NJIT-Highlander-Racing-Electrical/Pedal-Sensors/3D Models/Gas Pedal Sensor Adapter.step

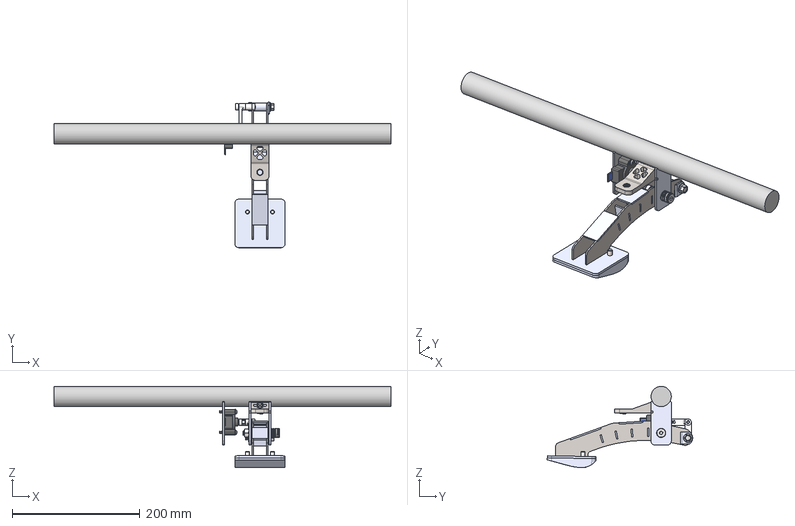
[picture p1: CAD file, 2025-04-19, last stored version]
3D Models/Gas Pedal Sensor Adapter.step
528.2 x 228.2 x 127.4 mm
Gas Pedal Plate (without bend)
Pedal Stop Target
hex nut_ai_1 x 3
Pedal Reinforcement Plate
socket head cap screw_ai x 2
Throttle Cable Bolt Sleeve
Gas Pedal Side (right) 2.0 x 2
91259A628_Alloy Steel Shoulder Screw
Pedal Mounting Tabs 2.0 x 2
Pedal Stop Tab 2.0
3726N174_Corrosion-Resistant Stacked Wave Disc Spring
Throttle Clamp
Gas Pedal Gussets x 4
6389K625_Light Duty Dry-Running Nylon Sleeve Bearing x 2
Gas Pedal Curved Face Extension 1.0
hex nut_ai
92979A130_Zinc-Plated Grade 5 Steel Flanged Hex Head Screws
Rotary Hall Effect Pedal Sensor PSC360G2-F2AA-C0002-ERA360-05K
92095A197_Button Head Hex Drive Screw x 2
98269A430_Black-Oxide 18-8 Stainless Steel Washer x 2
Upper Linkage
Lower Linkage (+90, original)
Tab
Retaining Clip 2
Retaining Clip
