NJIT-Highlander-Racing-Electrical/Pedal-Sensors/(list of files, cad)

Other CAD files:
3D Models/Gas Pedal Sensor Adapter.f3z
