NJIT-Highlander-Racing-Electrical/Pedal-Sensors/PCB/PedalPCB.kicad_pcb

## KiCad design PCB/PedalPCB.kicad_pcb (2024-12-06, last stored version)

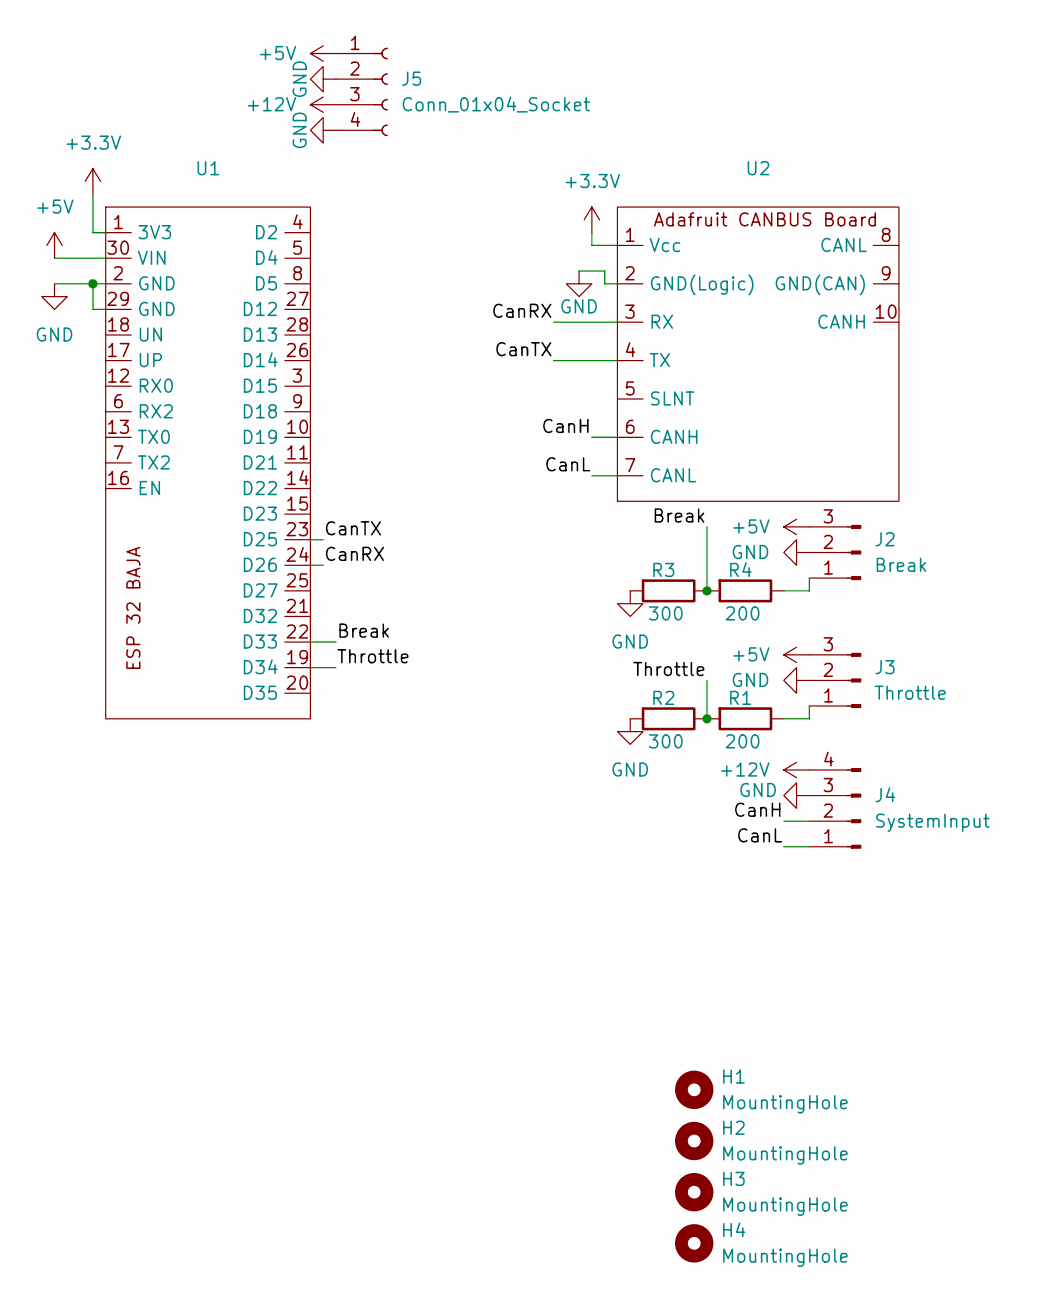
[picture p2: schematic PedalPCB.kicad_sch]

Parts:
H1, H2, H3, H4: MountingHole; MountingHole_4.3mm_M4
J2: Break; 3pin
J3: Throttle; 3pin
J4: SystemInput; JST4Pin
J5: Conn_01x04_Socket; PowerBoard
R1, R4: 200; R_Axial_DIN0204_L3.6mm_D1.6mm_P5.08mm_Horizontal
R2, R3: 300; R_Axial_DIN0204_L3.6mm_D1.6mm_P5.08mm_Horizontal
U1: ESP 32 BAJA
U2: 1x7 Connectors

Connections:
+3.3V: U1.1 (3V3), U2.1 (Vcc)
+5V: J2.3, J3.3, J5.1 (+5v), U1.30 (VIN)
+12V: J4.4, J5.3 (12+)
/Break: R3.1, R4.2, U1.22 (D33)
/CanH: J4.2, U2.6 (CANH)
/CanL: J4.1, U2.7 (CANL)
/CanRX: U1.24 (D26), U2.3 (RX)
/CanTX: U1.23 (D25), U2.4 (TX)
/Throttle: R1.2, R2.1, U1.19 (D34)
GND: J2.2, J3.2, J4.3, J5.2 (GND), J5.4 (GND), R2.2, R3.2, U1.2 (GND), U1.29 (GND), U2.2 (GND(Logic))
unnamed: J2.1, R4.1
unnamed: J3.1, R1.1

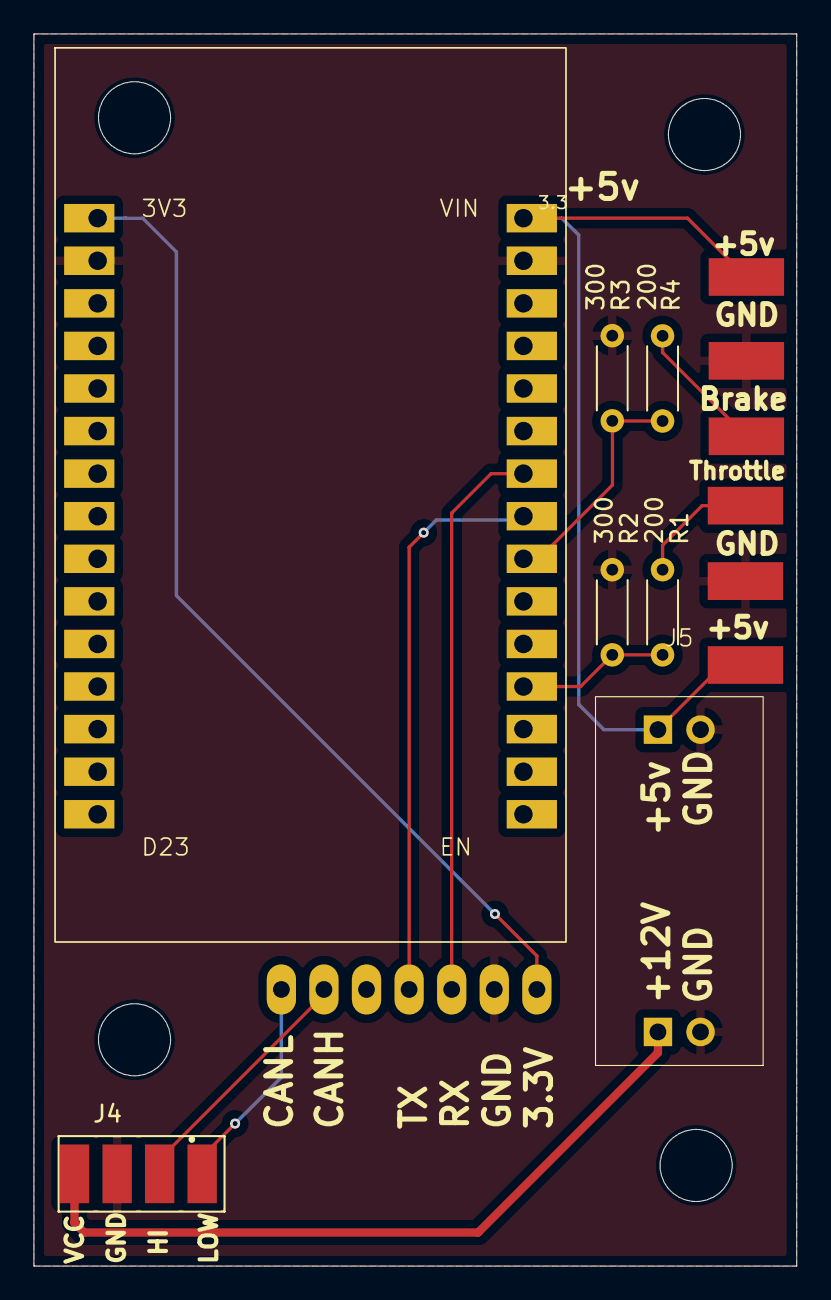
[picture p3: board PedalPCB.kicad_pcb from above]

Board: 2 copper layers, 45.5 x 73.5 mm, 14 parts (1 on the bottom side), 12 nets.

Other parts of the board:
H1#2: MountingHole; MountingHole_4.3mm_M4
