NJIT-Highlander-Racing-Electrical/Pedal-Sensors/(commit log)

2024-11-17 Add first iteration of uniform enclosure design
2024-12-06 Add first version of pedal sensors code
2024-12-06 Update PCB to purchased version
    [PedalPCB.kicad_pcb]
2025-01-07 Update to latest CAN driver
2025-03-29 Update to latest BajaCAN.h driver
2025-04-12 Update code to check brake pressure sensors
2025-04-12 Increase Serial Print rate to 460800
    So that way we spend less time printing and more time collecting data
2025-04-12 Add offset transformation for pressure sensors (see desc)
    Not sure why, but the analog reading value is consistently slightly less than it should be. Originally I though something was wrong with the voltage divider or software, but it appears to be an issue internal to the ESP32/ADC. When I measured 0.50V from the sensor on the analog pin, the ESP32 would report an analog reading that corresponded to an input voltage of ~0.32. This result carried through for 1V, 2V, 3V, etc. It appears to be linearly incorrect, so I added an offset function that ensures the pin voltage is accurately reconstructed after ADC processing
2025-04-19 Add 3d models
    [Gas Pedal Sensor Adapter.f3z, Gas Pedal Sensor Adapter.step]
2025-05-10 Make pedal sensor reading only an int not a float
2025-09-06 Uploaded latest CAN program (40Hz)
2025-11-05 Replace old files with platformio project files
    [Gas Pedal Sensor Adapter.f3z, Gas Pedal Sensor Adapter.step, PedalPCB.kicad_pcb, PedalPCB.kicad_sch]
